haiha-ux/pcb-rp2040-usbc/renders/pcb_3d_bottom.png

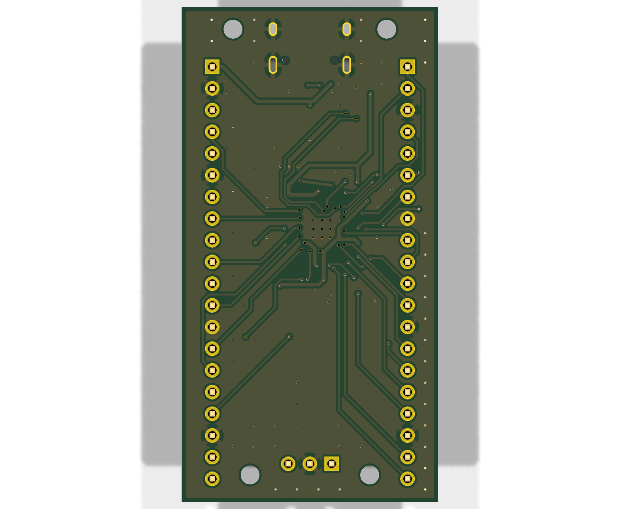
renders/pcb_3d_bottom.png
