haiha-ux/pcb-rp2040-usbc/fab/rp2040_usbc-BOM.csv

Designator | Comment | Footprint | Manufacturer | MPN | LCSC Part # | Spec | Qty
C1,C2,C17 | 10u | Capacitor_SMD:C_0805_2012Metric | Samsung Electro-Mechanics | CL21A106KAYNNNE | C15850 |  | 3
C3,C4 | 15p | Capacitor_SMD:C_0402_1005Metric | FH | 0402CG150J500NT | C1548 |  | 2
C5-C7,C9,C11-C16 | 100n | Capacitor_SMD:C_0402_1005Metric | Samsung Electro-Mechanics | CL05B104KO5NNNC | C1525 |  | 10
C8,C10 | 1u | Capacitor_SMD:C_0402_1005Metric | Samsung Electro-Mechanics | CL05A105KA5NQNC | C52923 |  | 2
D1 | RED | LED_SMD:LED_0603_1608Metric | Hubei KENTO Elec | KT-0603R | C2286 |  | 1
H1-H4 | M2 | MountingHole:MountingHole_2.2mm_M2 |  |  |  |  | 4
J1 | TYPE-C-31-M-12 | Connector_USB:USB_C_Receptacle_HRO_TYPE-C-31-M-12 | Korean Hroparts Elec | TYPE-C-31-M-12 | C165948 |  | 1
J2 | GPIO L | Connector_PinHeader_2.54mm:PinHeader_1x20_P2.54mm_Vertical | BOOMELE | 2.54-1*20PStraight pin | C50981 |  | 1
J3 | GPIO R | Connector_PinHeader_2.54mm:PinHeader_1x20_P2.54mm_Vertical | BOOMELE | 2.54-1*20PStraight pin | C50981 |  | 1
J4 | SWD | Connector_PinHeader_2.54mm:PinHeader_1x03_P2.54mm_Vertical | Molex | 22284030 | C587036 |  | 1
R1,R5,R8 | 1k | Resistor_SMD:R_0402_1005Metric | UNI-ROYAL | 0402WGF1001TCE | C11702 |  | 3
R3,R4 | 27 | Resistor_SMD:R_0402_1005Metric | FOJAN | FRC0402F27R0TS | C2909343 |  | 2
R6,R7 | 5.1k | Resistor_SMD:R_0402_1005Metric | UNI-ROYAL | 0402WGF5101TCE | C25905 |  | 2
R9 | 10k | Resistor_SMD:R_0402_1005Metric | UNI-ROYAL | 0402WGF1002TCE | C25744 |  | 1
SW1 | BOOTSEL | Button_Switch_SMD:SW_Push_1P1T_XKB_TS-1187A | XKB Connection | TS-1187A-B-A-B | C318884 |  | 1
SW2 | RESET | Button_Switch_SMD:SW_Push_1P1T_XKB_TS-1187A | XKB Connection | TS-1187A-B-A-B | C318884 |  | 1
U1 | AP2112K-3.3 | Package_TO_SOT_SMD:SOT-23-5 | Diodes Incorporated | AP2112K-3.3TRG1 | C51118 |  | 1
U2 | RP2040 | Package_DFN_QFN:QFN-56-1EP_7x7mm_P0.4mm_EP3.2x3.2mm | Raspberry Pi | RP2040 | C2040 |  | 1
U3 | W25Q128JVSIQ | Package_SO:SOIC-8_5.3x5.3mm_P1.27mm | Winbond | W25Q128JVSIQ | C97521 |  | 1
U4 | USBLC6-2SC6 | Package_TO_SOT_SMD:SOT-23-6 | STMicroelectronics | USBLC6-2SC6 | C7519 |  | 1
Y1 | 12MHz | Crystal:Crystal_SMD_3225-4Pin_3.2x2.5mm | Abracon | ABM8-272-T3 | C20625731 |  | 1
