haiha-ux/pcb-rp2040-usbc/rp2040_usbc_schematic.pdf

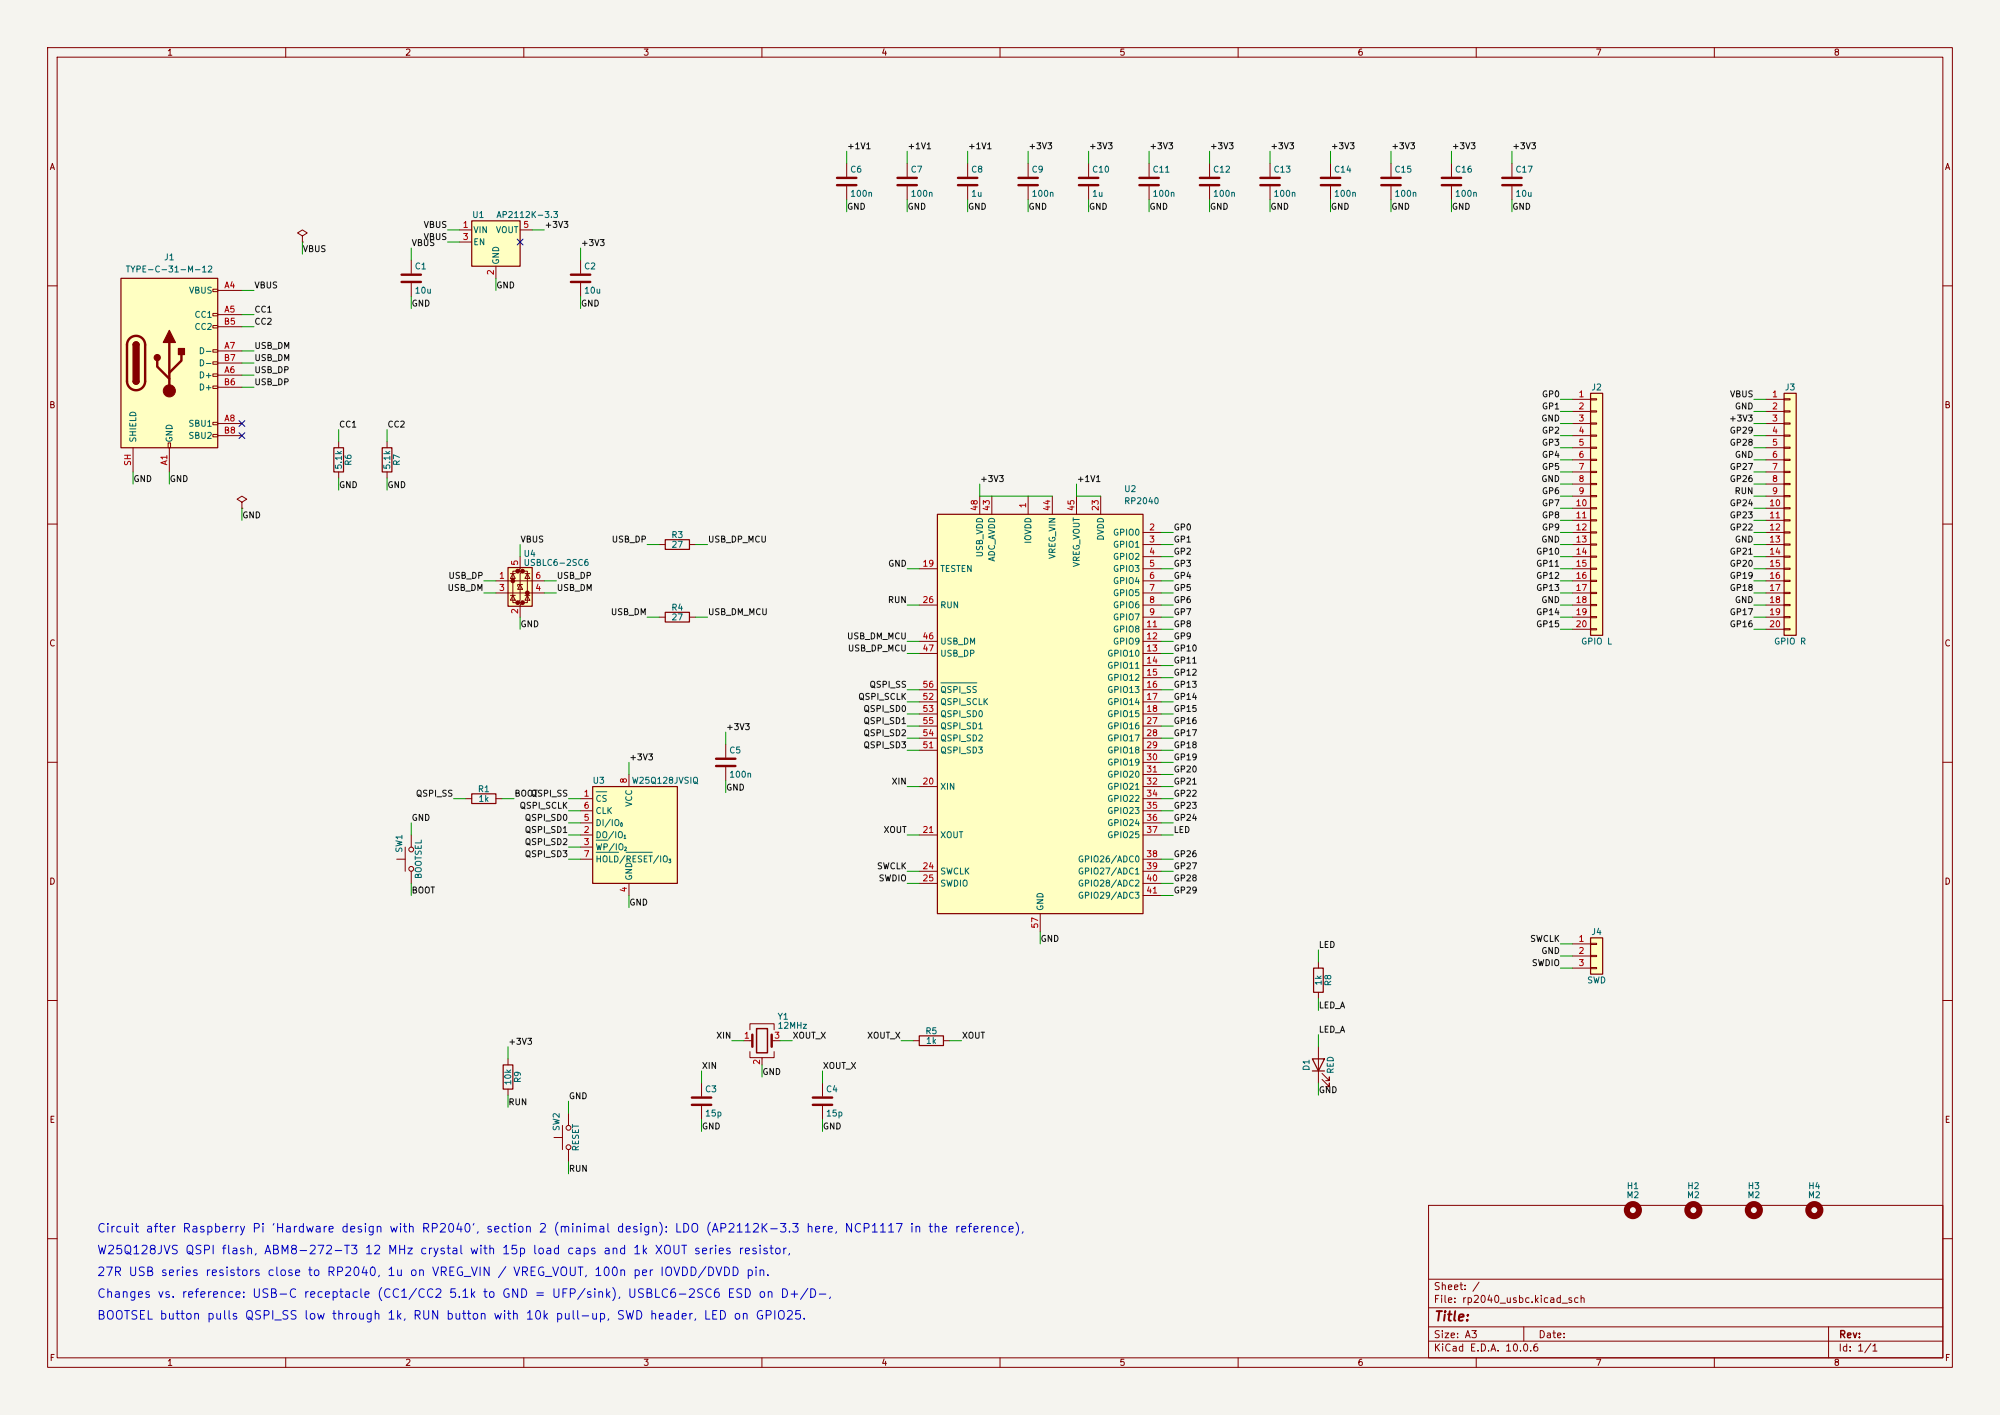
[picture p8: page 1]

VBUS Circuit after Raspberry Pi 'Hardware design with RP2040', section 2 (minimal design): LDO (AP2112K-3.3 here, NCP1117 in the reference),

4 DI/IO0 5 CLK 6 HOLD/RESET/IO3 7 VCC U3 8W25Q128JVSIQ R6 5.1k R7 5.1k

W25Q128JVS QSPI flash, ABM8-272-T3 12 MHz crystal with 15p load caps and 1k XOUT series resistor,
27R USB series resistors close to RP2040, 1u on VREG_VIN / VREG_VOUT, 100n per IOVDD/DVDD pin.
Changes vs. reference: USB-C receptacle (CC1/CC2 5.1k to GND = UFP/sink), USBLC6-2SC6 ESD on D+/D-,
BOOTSEL button pulls QSPI_SS low through 1k, RUN button with 10k pull-up, SWD header, LED on GPIO25.

Size: A3 | Rev: | F Date:
KiCad E.D.A. 10.0.6 | Id: 1/1
