haiha-ux/pcb-rp2040-usbc/rp2040_usbc.kicad_pcb

## KiCad design rp2040_usbc.kicad_pcb (2026-10-30)

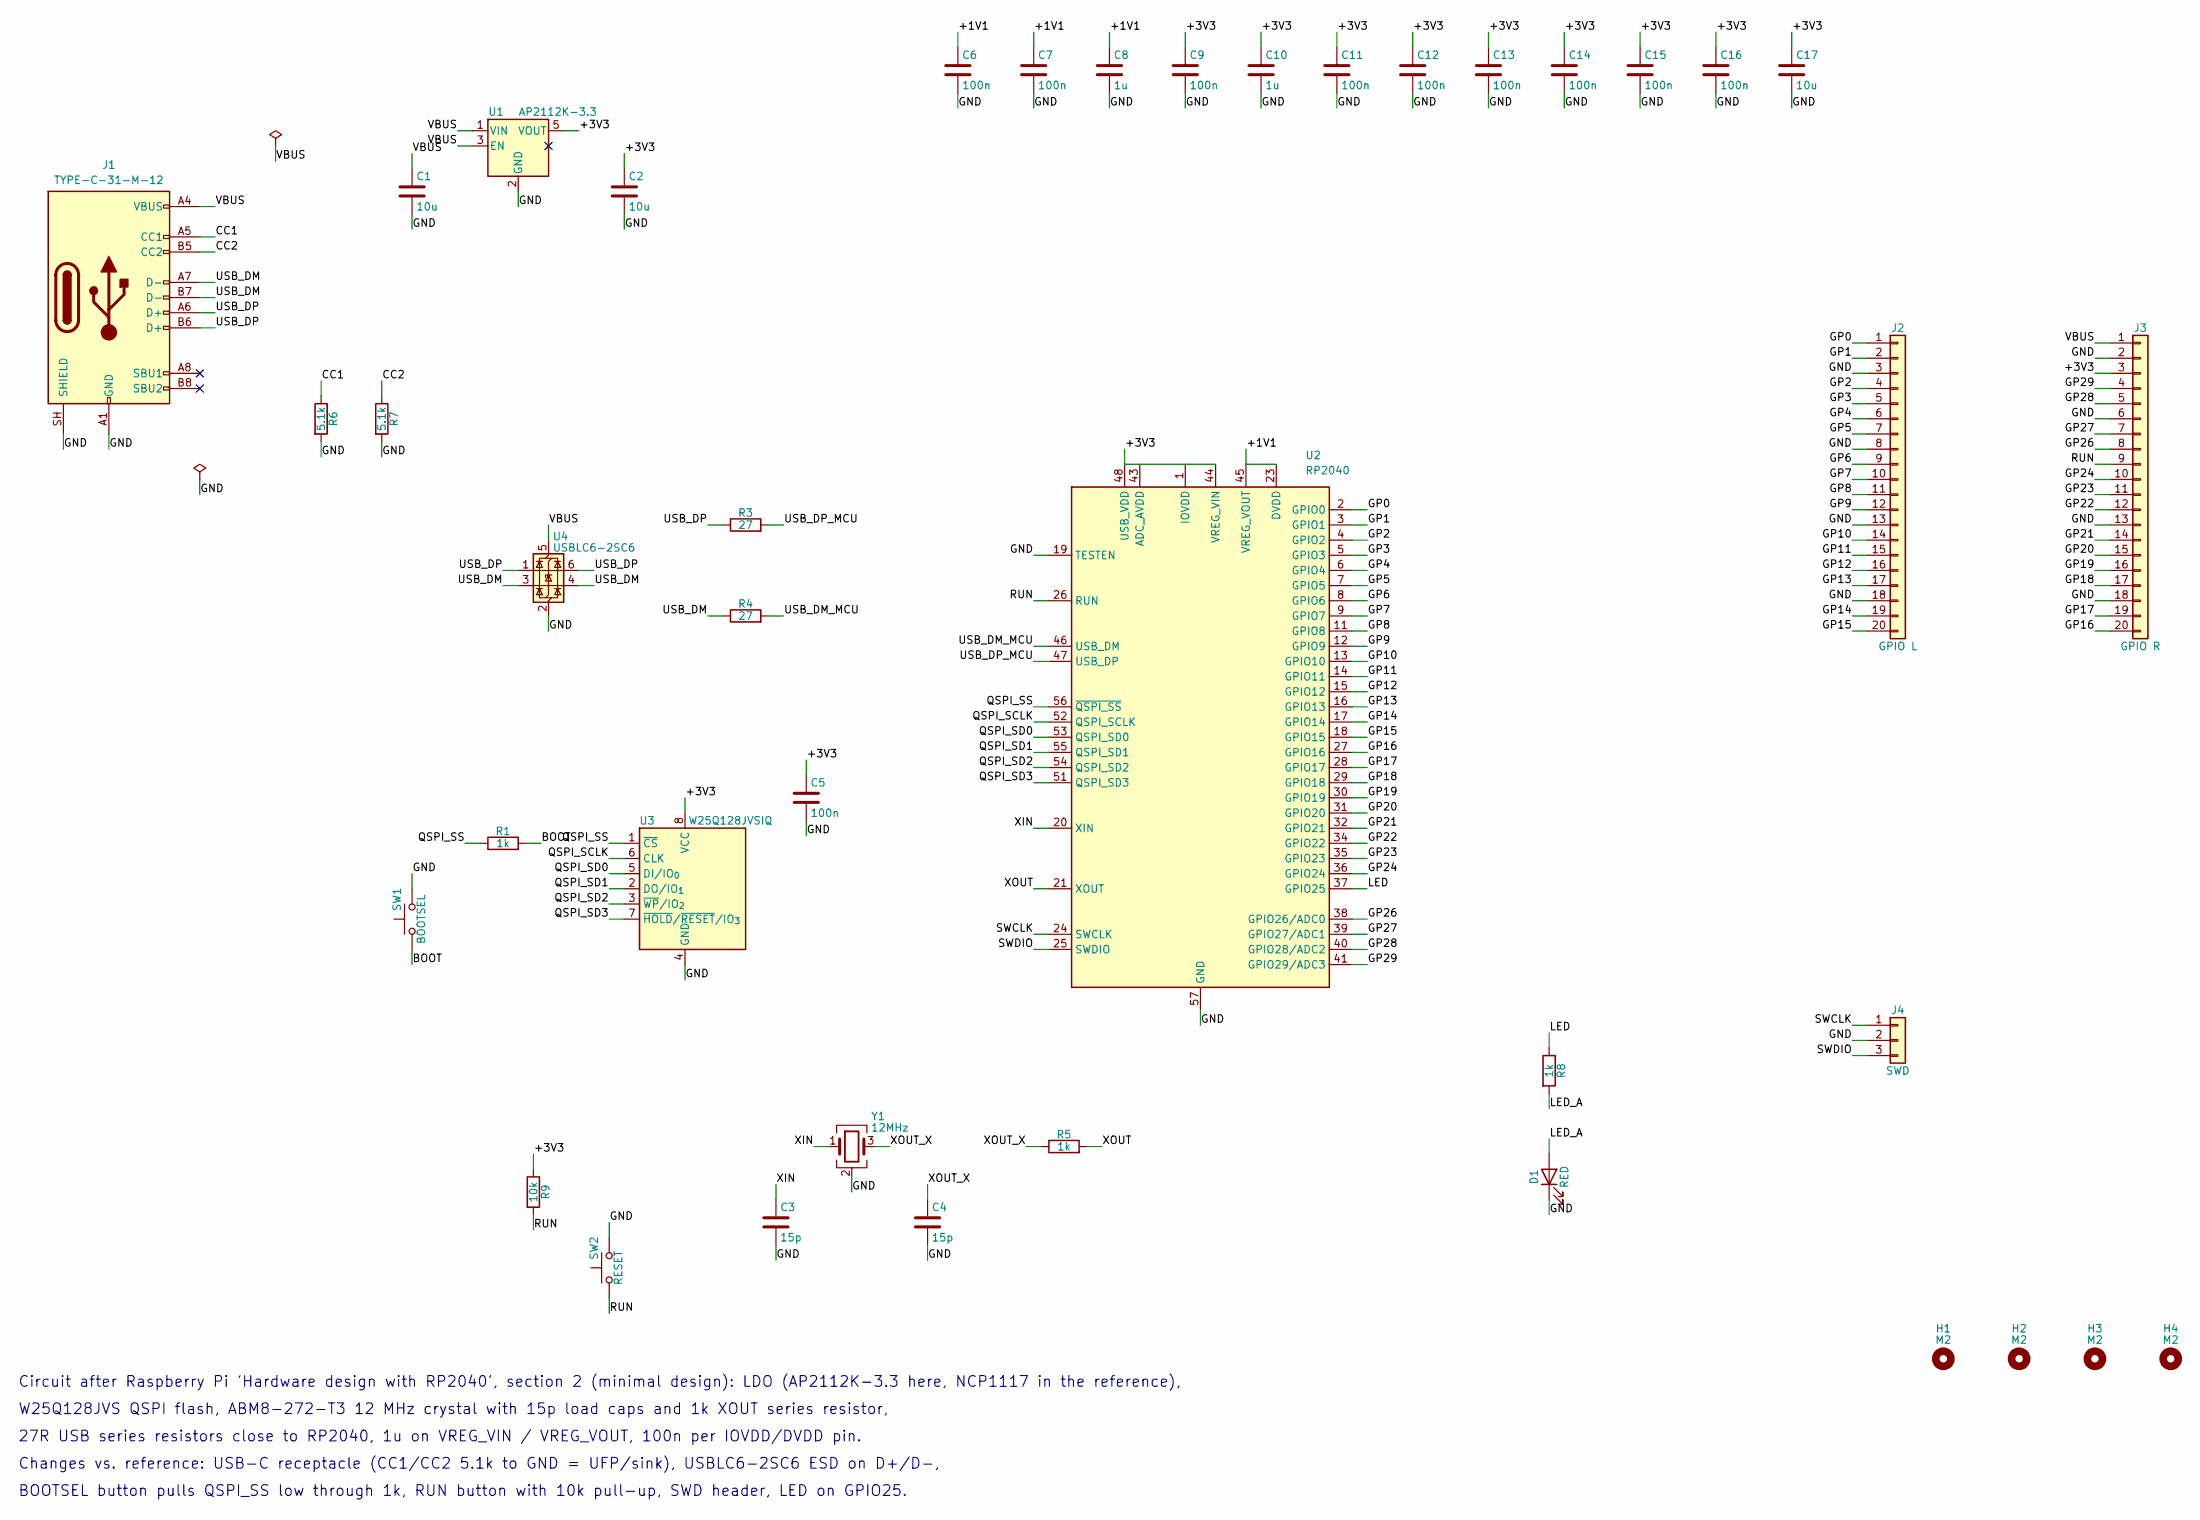
[picture p9: schematic rp2040_usbc.kicad_sch]

Parts:
C1, C2, C17: 10u; C_0805_2012Metric; MPN CL21A106KAYNNNE; LCSC C15850
C3, C4: 15p; C_0402_1005Metric; MPN 0402CG150J500NT; LCSC C1548
C5, C6, C7, C9, C11, C12, C13, C14, C15, C16: 100n; C_0402_1005Metric; MPN CL05B104KO5NNNC; LCSC C1525
C8, C10: 1u; C_0402_1005Metric; MPN CL05A105KA5NQNC; LCSC C52923
D1: RED; LED_0603_1608Metric; MPN KT-0603R; LCSC C2286
H1, H2, H3, H4: M2; MountingHole_2.2mm_M2
J1: TYPE-C-31-M-12; USB_C_Receptacle_HRO_TYPE-C-31-M-12; MPN TYPE-C-31-M-12; LCSC C165948
J2: GPIO L; PinHeader_1x20_P2.54mm_Vertical; MPN 2.54-1*20PStraight pin; LCSC C50981
J3: GPIO R; PinHeader_1x20_P2.54mm_Vertical; MPN 2.54-1*20PStraight pin; LCSC C50981
J4: SWD; PinHeader_1x03_P2.54mm_Vertical; MPN 22284030; LCSC C587036
R1, R5, R8: 1k; R_0402_1005Metric; MPN 0402WGF1001TCE; LCSC C11702
R3, R4: 27; R_0402_1005Metric; MPN FRC0402F27R0TS; LCSC C2909343
R6, R7: 5.1k; R_0402_1005Metric; MPN 0402WGF5101TCE; LCSC C25905
R9: 10k; R_0402_1005Metric; MPN 0402WGF1002TCE; LCSC C25744
SW1: BOOTSEL; SW_Push_1P1T_XKB_TS-1187A; MPN TS-1187A-B-A-B; LCSC C318884
SW2: RESET; SW_Push_1P1T_XKB_TS-1187A; MPN TS-1187A-B-A-B; LCSC C318884
U1: AP2112K-3.3; SOT-23-5; MPN AP2112K-3.3TRG1; LCSC C51118
U2: RP2040; QFN-56-1EP_7x7mm_P0.4mm_EP3.2x3.2mm; MPN RP2040; LCSC C2040
U3: W25Q128JVSIQ; SOIC-8_5.3x5.3mm_P1.27mm; MPN W25Q128JVSIQ; LCSC C97521
U4: USBLC6-2SC6; SOT-23-6; MPN USBLC6-2SC6; LCSC C7519
Y1: 12MHz; Crystal_SMD_3225-4Pin_3.2x2.5mm; MPN ABM8-272-T3; LCSC C20625731

Connections:
/+1V1: C6.1, C7.1, C8.1, U2.23 (DVDD), U2.45 (VREG_VOUT), U2.50 (DVDD)
/+3V3: C2.1, C5.1, C9.1, C10.1, C11.1, C12.1, C13.1, C14.1, C15.1, C16.1, C17.1, J3.3, R9.1, U1.5 (VOUT), U2.1 (IOVDD), U2.10 (IOVDD), U2.22 (IOVDD), U2.33 (IOVDD), U2.42 (IOVDD), U2.43 (ADC_AVDD), U2.44 (VREG_VIN), U2.48 (USB_VDD), U2.49 (IOVDD), U3.8 (VCC)
/BOOT: R1.2, SW1.1
/CC1: J1.A5 (CC1), R6.1
/CC2: J1.B5 (CC2), R7.1
/GND: C1.2, C2.2, C3.2, C4.2, C5.2, C6.2, C7.2, C8.2, C9.2, C10.2, C11.2, C12.2, C13.2, C14.2, C15.2, C16.2, C17.2, D1.1 (K), J1.A1 (GND), J1.A12 (GND), J1.B1 (GND), J1.B12 (GND), J1.SH (SHIELD), J2.3, J2.8, J2.13, J2.18, J3.2, J3.6, J3.13, J3.18, J4.2, R6.2, R7.2, SW1.2, SW2.2, U1.2 (GND), U2.19 (TESTEN), U2.57 (GND), U3.4 (GND), U4.2 (GND), Y1.2 (G), Y1.4 (G)
/GP0: J2.1, U2.2 (GPIO0)
/GP1: J2.2, U2.3 (GPIO1)
/GP2: J2.4, U2.4 (GPIO2)
/GP3: J2.5, U2.5 (GPIO3)
/GP4: J2.6, U2.6 (GPIO4)
/GP5: J2.7, U2.7 (GPIO5)
/GP6: J2.9, U2.8 (GPIO6)
/GP7: J2.10, U2.9 (GPIO7)
/GP8: J2.11, U2.11 (GPIO8)
/GP9: J2.12, U2.12 (GPIO9)
/GP10: J2.14, U2.13 (GPIO10)
/GP11: J2.15, U2.14 (GPIO11)
/GP12: J2.16, U2.15 (GPIO12)
/GP13: J2.17, U2.16 (GPIO13)
/GP14: J2.19, U2.17 (GPIO14)
/GP15: J2.20, U2.18 (GPIO15)
/GP16: J3.20, U2.27 (GPIO16)
/GP17: J3.19, U2.28 (GPIO17)
/GP18: J3.17, U2.29 (GPIO18)
/GP19: J3.16, U2.30 (GPIO19)
/GP20: J3.15, U2.31 (GPIO20)
/GP21: J3.14, U2.32 (GPIO21)
/GP22: J3.12, U2.34 (GPIO22)
/GP23: J3.11, U2.35 (GPIO23)
/GP24: J3.10, U2.36 (GPIO24)
/GP26: J3.8, U2.38 (GPIO26/ADC0)
/GP27: J3.7, U2.39 (GPIO27/ADC1)
/GP28: J3.5, U2.40 (GPIO28/ADC2)
/GP29: J3.4, U2.41 (GPIO29/ADC3)
/LED: R8.1, U2.37 (GPIO25)
/LED_A: D1.2 (A), R8.2
/QSPI_SCLK: U2.52 (QSPI_SCLK), U3.6 (CLK)
/QSPI_SD0: U2.53 (QSPI_SD0), U3.5 (DI/IO_{0})
/QSPI_SD1: U2.55 (QSPI_SD1), U3.2 (DO/IO_{1})
/QSPI_SD2: U2.54 (QSPI_SD2), U3.3 (~WP/IO_{2})
/QSPI_SD3: U2.51 (QSPI_SD3), U3.7 (~HOLD/~RESET/IO_{3})
/QSPI_SS: R1.1, U2.56 (~QSPI_SS), U3.1 (~CS)
/RUN: J3.9, R9.2, SW2.1, U2.26 (RUN)
/SWCLK: J4.1, U2.24 (SWCLK)
/SWDIO: J4.3, U2.25 (SWDIO)
/USB_DM: J1.A7 (D-), J1.B7 (D-), R4.1, U4.3 (I/O2), U4.4 (I/O2)
/USB_DM_MCU: R4.2, U2.46 (USB_DM)
/USB_DP: J1.A6 (D+), J1.B6 (D+), R3.1, U4.1 (I/O1), U4.6 (I/O1)
/USB_DP_MCU: R3.2, U2.47 (USB_DP)
/VBUS: C1.1, J1.A4 (VBUS), J1.A9 (VBUS), J1.B4 (VBUS), J1.B9 (VBUS), J3.1, U1.1 (VIN), U1.3 (EN), U4.5 (VBUS)
/XIN: C3.1, U2.20 (XIN), Y1.1
/XOUT: R5.2, U2.21 (XOUT)
/XOUT_X: C4.1, R5.1, Y1.3

Notes on the sheet:
Circuit after Raspberry Pi 'Hardware design with RP2040', section 2 (minimal design): LDO (AP2112K-3.3 here, NCP1117 in the reference),
W25Q128JVS QSPI flash, ABM8-272-T3 12 MHz crystal with 15p load caps and 1k XOUT series resistor,
27R USB series resistors close to RP2040, 1u on VREG_VIN / VREG_VOUT, 100n per IOVDD/DVDD pin.
Changes vs. reference: USB-C receptacle (CC1/CC2 5.1k to GND = UFP/sink), USBLC6-2SC6 ESD on D+/D-,
BOOTSEL button pulls QSPI_SS low through 1k, RUN button with 10k pull-up, SWD header, LED on GPIO25.

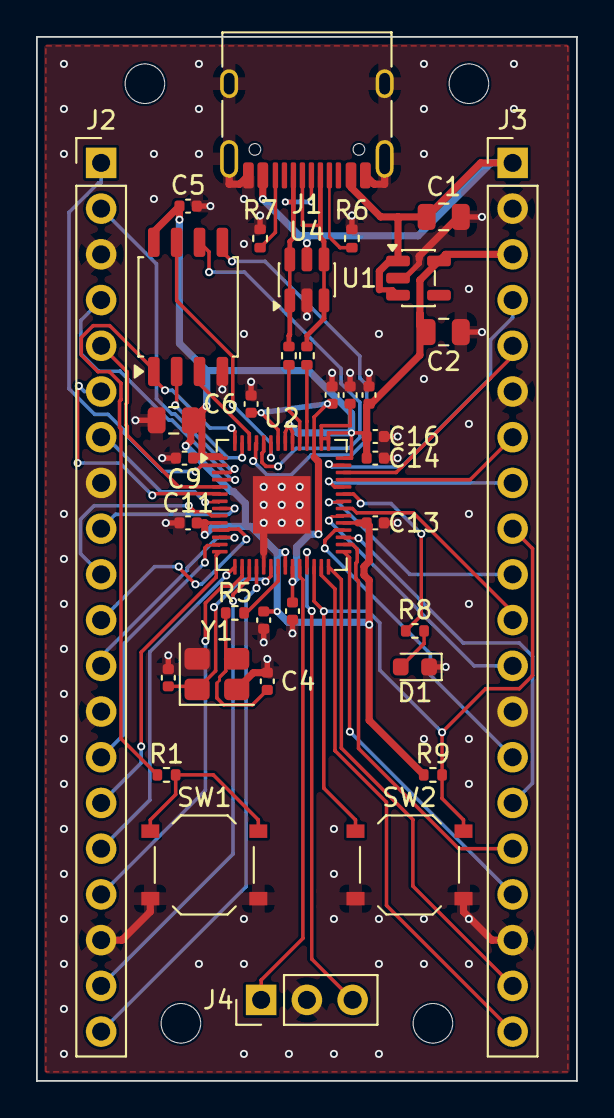
[picture p10: board rp2040_usbc.kicad_pcb from above]

Board: 4 copper layers, 30.0 x 58.0 mm, 41 parts (0 on the bottom side), 54 nets.
